olikraus/stm32f407/stm32f407_boot_mode_pcb.jpg

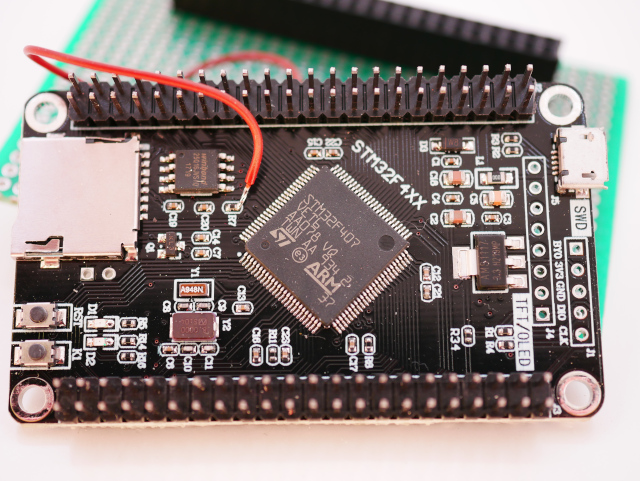
stm32f407_boot_mode_pcb.jpg
