olikraus/stm32f407/(commit log)

2022-05-15 touch sensor
2022-12-22 boot mode pin
